Aapjedotinfo/atlantic-aurea-esphome/README.md

# Aurea WP — de complete controlbox van de Atlantic Aurea vervangen

Alternatieve besturing voor de **Atlantic Aurea 5 Hybrid** warmtepomp (een
kostenbespaarde **Chofu AEYC-0643XU**). In de controlbox zitten twee ATmega8's in
een DIP28-voet. **IC1 vervang je altijd door een ESP32; wat je in IC2 zet, bepaalt hoe ver
je komt met thermostaat en CV-ketel** (zie *Kies je opzet*):

| Voet | Origineel | Wordt | Doet |
|---|---|---|---|
| **IC1** | Haddon M1.1 | **ESP32** (MH-ET MiniKit) | praat op 666 baud met de buitenunit, draait de regeling, praat met Home Assistant |
| **IC2** | Haddon T1.1 | naar keuze: leeg, de originele chip, of een **ATmega328P** met eigen firmware | het OpenTherm-gesprek tussen thermostaat en CV-ketel |

Je zegt vanuit Home Assistant *"geef me X °C aanvoer"* en de controller kiest zelf
de stand. Met een chip in IC2 zit de controlbox tussen je thermostaat en je ketel in,
dus kun je de ketel **blokkeren** zolang de warmtepomp het alleen aankan — zonder de
thermostaat te misleiden en zonder draden te verleggen.

**Status: werkend op echte hardware.** Beide kanten van de OpenTherm-brug
decoderen frames zonder pariteitsfouten, met een echte thermostaat aan de ene
kant en een CV-ketel aan de andere. De warmtepompkant draait al langer: alle
telegrammen CRC-geldig, en de buitenunit reageert op de gestuurde stand.

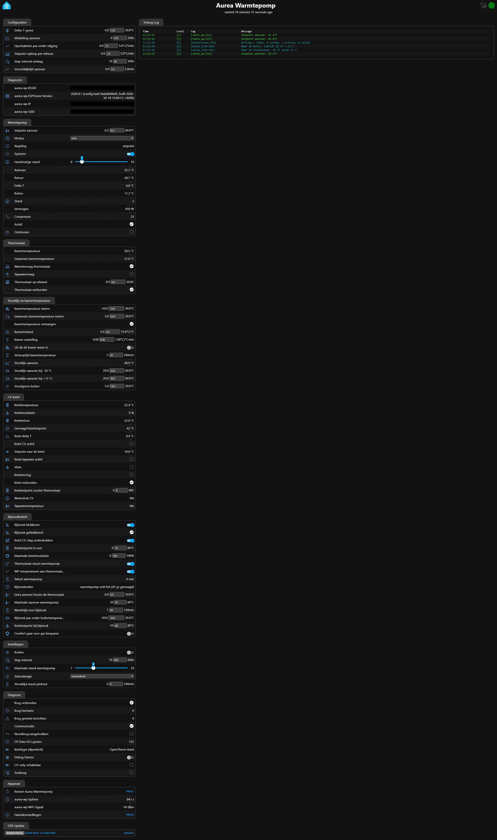
[picture p1: docs/esphome.jpg]
De webinterface, gegroepeerd met web_server v3


---

## Kies je opzet: wat doe je in IC1 en IC2?

**IC1 krijgt altijd de ESP32.** Die doet de warmtepomp: stand, stooklijn, kamertemperatuur, Home Assistant. Voor het
OpenTherm-gesprek tussen thermostaat en CV-ketel loopt er een link tussen IC1 en IC2, en daar zit de keuze. De regel is:
**hoe meer van dat gesprek jij in handen hebt, hoe meer je ziet en kunt sturen.** De originele IC2 voert het gesprek zelf en
geeft alleen twee setpoints door; een eigen AVR geeft elk frame door aan de ESP32.

| | 1. Minimaal | 2. Originele IC2 (`org`) | 3. Eigen AVR **v1** | 4. Eigen AVR **v2** |
|---|---|---|---|---|
| In de IC2-voet | leeg | de originele ATmega8 | ATmega328P, eigen firmware | ATmega328P, eigen firmware |
| Zelf een chip branden | nee | **nee** | ja | ja |
| `avr_versie` in de yaml | (minimaal-voorbeeld) | `"org"` | `"1"` | `"2"` |
| Warmtepomp, stooklijn, kamerregeling | ✅ | ✅ | ✅ | ✅ |
| Kamertemperatuur van de thermostaat | — (via HA of HTTP) | — (via HA of HTTP) | ✅ | ✅ |
| Gewenste kamertemperatuur en ketelsetpoint van de thermostaat | — | ✅ | ✅ | ✅ |
| Ketelgegevens (aanvoer, retour, druk, modulatie, vlam, storing) | — | — | ✅ | ✅ |
| Elk OpenTherm-Data-ID zien | — | — | ✅ | ✅ |
| Ketel tegenhouden zolang de warmtepomp het aankan | — (ketel los) | alles of niets | ✅ met instelbaar setpoint | ✅ met instelbaar setpoint |
| Bijstook op een gekozen ketelsetpoint | — | — | ✅ | ✅ |
| Warmtepomptemperaturen aan de thermostaat tonen | — | ✅ | ✅ | ✅ |
| Buitentemperatuur aan de thermostaat | — | — | — | ✅ |
| Ketelpolariteit instelbaar (schakelaars "Ketel leesrichting/zendpolariteit omkeren", "Kanalen verwisselen") en ketel-diagnose | — | — (staat vast in de originele IC2) | ✅ | ✅ |
| Aan/uit-ketel op het contact van K3 (schakelaar "Ketel aan-uit-contact") | — | ✅ met dipswitch 2 OFF, geen terugmelding | ✅ (ketelklemmen krijgen nog OpenTherm, onschuldig) | ✅ geen OpenTherm naar de ketel |
| Noodbrug als de ESP32 wegvalt | — | ✅ (240 s) | ✅ | ✅ |
| Extra bedrading | alleen GPIO16/17 | + deler op GPIO19 | + deler op GPIO19 | + deler op GPIO19 |
| Terug naar fabrieksstaat | origineel in IC2 | origineel blijft zitten | origineel bewaren | origineel bewaren |
| Getest op echte hardware | ✅ (warmtepomp) | ❌ nog niet | v1 eerder wel; na de herstructurering niet | ✅ één opstelling (26-10-2026) |

**Welke kies je?**

- *Alleen de warmtepomp in Home Assistant, ketel en thermostaat blijven zoals ze zijn:* **1, minimaal.** Ook de beste
  eerste stap om te zien dat je bedrading klopt, en de terugval als er iets mis is.
- *De ketel automatisch laten meewerken, maar je kunt of wilt geen AVR programmeren:* **2, de originele IC2.** Je ziet minder
  en de bijstook is grof, maar je hoeft niets te branden. Experimenteel.
- *Alles zien en sturen, of een ketel/thermostaat die iets bijzonders vraagt:* **4, eigen AVR v2.** Nieuwe bouwers die
  willen branden kiezen v2. v1 blijft werken voor bestaande opstellingen.
- *Een Data-ID, de buitentemperatuur naar de thermostaat of een regeltabel per ID:* alleen **v2**.

De keuze maak je met `avr_versie` bovenin `aurea-wp.yaml`; laat je hem staan, dan compileert het bestand niet (de
foutmelding noemt `avr-brug-vKIES_1_2_OF_ORG...`). Optie 1 kies je door het minimaal-voorbeeld over `aurea-wp.yaml` heen te
kopiëren. Meer per optie hieronder.

### Optie 1: minimaal (IC2-voet leeg)

`aurea-wp.yaml` is de volledige opzet. Wil je alleen de warmtepomp en laat je de
IC2-voet leeg, dan ligt er een uitgeklede variant klaar als
[`aurea-wp-minimaal.yaml.example`](aurea-wp-minimaal.yaml.example):

| | minimaal | volledig |
|---|---|---|
| ESP32 in IC1 | ✅ | ✅ |
| Eigen chip in IC2 | — (voet blijft leeg) | ✅ ATmega328P |
| Warmtepomp aansturen | ✅ volledig | ✅ volledig |
| Stooklijn / kamertemperatuur | ✅ (kamer via HA of HTTP) | ✅ (kamer van de OT-thermostaat, of HA/HTTP) |
| Thermostaat & CV-ketel | los aansturen, zoals voorheen | via de OpenTherm-brug |
| Extra bedrading | alleen GPIO16/17 | + een deler op GPIO19 |

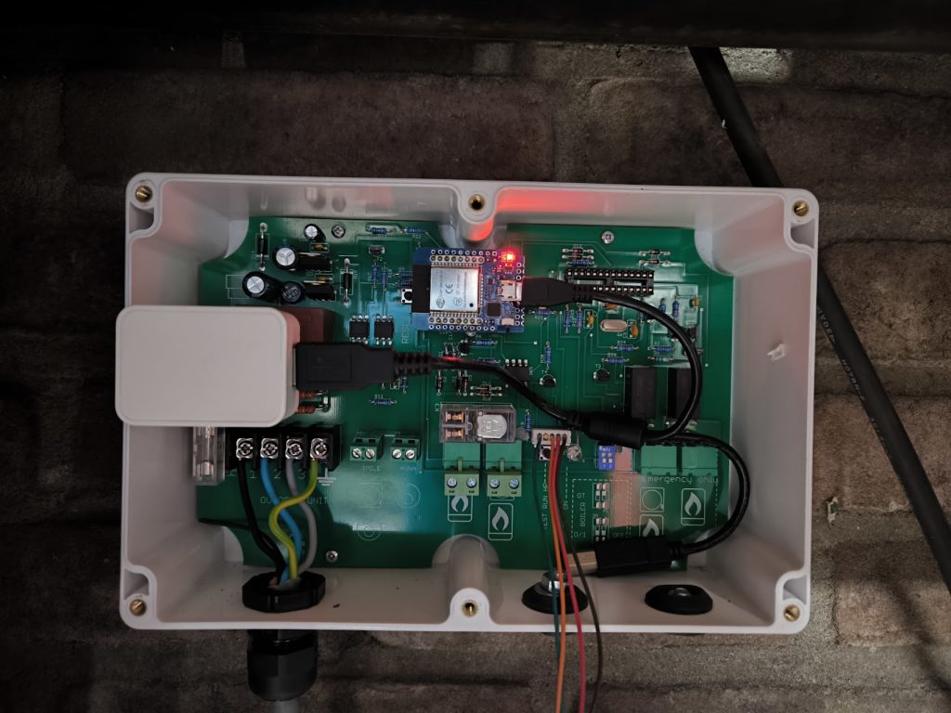
[picture p2: docs/controlbox-esp32.jpg]
Minimale opzet: alleen de ESP32 in de IC1-voet


***Minimale opzet.*** *De ESP32 op de plek van de linker ATmega; de rechter voet
blijft leeg. De warmtepomp draait volledig, de CV-ketel stuur je los aan.*

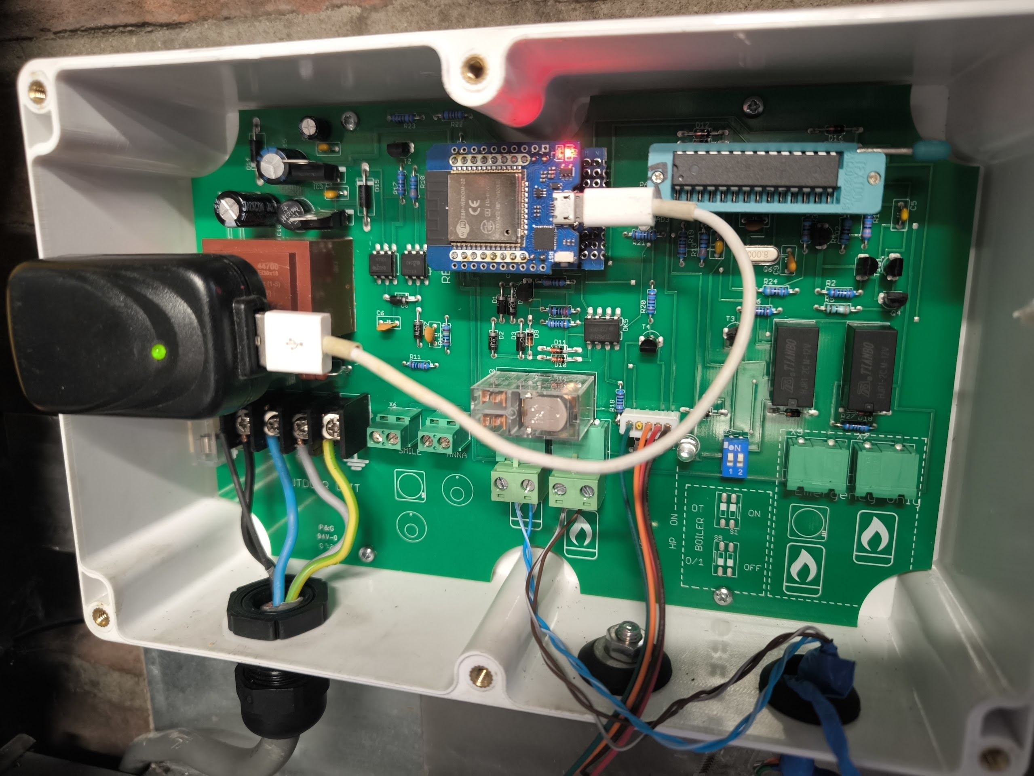
[picture p3: docs/controlboxv2.jpg]
Uitgebreide opzet: beide chips vervangen


***Uitgebreide opzet met IC2-aansturing.*** *Links de ESP32, rechts de eigen
ATmega328P — hier in een ZIF-voet, zodat je de chip zonder gereedschap kunt
wisselen. Voeding via een USB-adapter. Rechtsonder staat op de zeefdruk
`OT BOILER` / `O/1` bij de dipswitch en `Emergency only` bij de klemmen van de
noodbrug.*

Gebruik de minimale opzet door hem over `aurea-wp.yaml` heen te kopiëren:

```bash
cp aurea-wp-minimaal.yaml.example aurea-wp.yaml
```

**Handig om mee te beginnen.** Daarmee heb je de warmtepomp compleet in Home
Assistant en weet je zeker dat je bedrading klopt, vóórdat je een chip gaat
branden. Het is ook waar je op terugvalt als er iets mis is met de brug: de
warmtepomp blijft dan gewoon draaien.

Terug naar de volledige opzet is `git checkout aurea-wp.yaml`, gevolgd door
**`esphome clean aurea-wp.yaml`** — ESPHome kiest zijn bouwmap op de
apparaatnaam, dus de bouwmap van de vorige variant blijft anders staan en je
krijgt een linkfout over ontbrekende `aurea_link`-symbolen.

De apparaatnaam blijft in beide gevallen `aurea-wp`. Dat is bewust: Home
Assistant houdt daarmee het apparaat en de geschiedenis van alle sensoren die in
beide varianten zitten, en je krijgt er bij de volledige opzet alleen de
thermostaat- en ketelentiteiten bij.

### Optie 2: de originele IC2 laten zitten (`avr_versie: "org"`, experimenteel)

De originele ATmega8 (Haddon T1.1) kan gewoon in de IC2-voet blijven. Hij doet zelf het OpenTherm-gesprek met thermostaat en
ketel; de ESP32 praat met hem over de 9615-baud-link die al op de print ligt en speelt de rol van de originele IC1. Je hoeft
dan niets te branden. De prijs: de IC2 geeft veel minder door (geen kamertemperatuur, geen ketelgegevens, geen
buitentemperatuur naar de thermostaat, de ketelrem is alles-of-niets) en deze variant is **nog niet op een echte IC2
geprobeerd**. Begin met `org_alleen_luisteren: "true"`. Alles staat in [docs/ic2-origineel.md](docs/ic2-origineel.md).

### Optie 3 en 4: een eigen AVR in IC2 (v1 of v2)

Zit er een ATmega328P-brug in IC2, dan zijn er twee versies. Ze praten een ander protocol met de ESP32, dus de
firmware van de AVR en de yaml moeten bij elkaar passen:

| | AVR-brug **v1** | AVR-brug **v2** |
|---|---|---|
| Firmware | `firmware/avr-bridge/avr-bridge.hex` | `firmware/avr-bridge-v2/avr-bridge-v2.hex` |
| Link naar de ESP32 | 9600 baud | 38400 baud met CRC |
| Component | `aurea_link` | `aurea_link2` |
| Extra | | regeltabel per Data-ID, **buitentemperatuur naar de thermostaat (werkt alleen vanaf AVR v2)**, automatische TX-polariteit, versie in Diagnose |

**Nieuwe bouwers: kies v2.** v1 blijft werken voor bestaande opstellingen, maar krijgt geen nieuwe functies meer (de
buitentemperatuur naar de thermostaat werkt alleen met v2). De v1-variant van deze yaml compileert, maar is na de
herstructurering (keuze via `avr_versie`) niet op hardware gedraaid; ging het bij jou mis, dan staat de vorige stand op
de tag `voor-v2`. AVR v2 draait sinds 26-10-2026 op één opstelling (OpenTherm-ketel, Remeha iSense); op andere ketels
en thermostaten is hij nog niet getest.

**Bovenin `aurea-wp.yaml` staat `avr_versie`.** Zet die op `"1"` of `"2"`, naar de AVR die je hebt gebrand, of op `"org"` als je
de originele IC2 laat zitten (zie hieronder). Laat je hem staan, dan compileert het bestand niet (de foutmelding noemt
`avr-brug-vKIES_1_2_OF_ORG...`): je moet dus bewust kiezen.
Kies je de verkeerde versie, dan praten ESP32 en AVR niet met elkaar: *Brug verbonden* blijft uit en de warmtepomp
doet niet mee, terwijl de ketel de thermostaat blijft volgen (de brug valt terug; bij v2 na enkele minuten). Welke versie in de ESP32 verwacht wordt, zie je terug onder **Diagnose**
(*AVR-versie (verwacht)*; bij v2 ook *AVR-versie (gemeld)*). Meer over v2: [docs/avr-v2.md](docs/avr-v2.md).

## Wat je nodig hebt

### Voor IC1 — de warmtepompkant

Een **ESP32**; ontwikkeld op een MH-ET LIVE MiniKit, maar elk ESP32-bord met de
juiste pinnen vrij werkt. Zie [WIRING.md](WIRING.md).

### Voor IC2 — de OpenTherm-brug *(optioneel)*

Sla dit over als je de minimale opzet draait, of als je de originele IC2 laat zitten (optie 2): dan hoef je niets te
kopen of te branden. Wat hieronder staat gaat over een **eigen AVR** (optie 3 en 4).

Een **ATmega328P-PU in DIP-28**. Dat is dezelfde behuizing als de originele
ATmega8, dus hij past rechtstreeks in de bestaande voet.

> **Waarom een nieuwe chip en niet de originele overschrijven?**
>
> Omdat je terug wilt kunnen. Laat de originele ATmega8 heel en bewaar hem, dan
> is de controlbox in twee minuten weer fabrieksstaat: chips terug in de voet,
> draden los, klaar. Dat telt als je nog garantie hebt, als er een monteur langs
> moet komen, of als je het huis verkoopt. Overschrijf je de originelen, dan is
> die weg afgesloten — de firmware die erop stond krijg je nergens meer.
>
> **En waarom dan een 328P?** Dezelfde behuizing, dezelfde pinout, dezelfde
> registers, dus hij past rechtstreeks in de voet. Hij is overal te krijgen en
> kost een paar euro. Bovendien heeft hij viermaal zoveel flash en tweemaal
> zoveel RAM: de firmware gebruikt nu 7076 bytes, en op een ATmega8 hield je
> daar iets meer dan een kilobyte van over.

Wat je verder nodig hebt:

- Iets om de chip mee te branden. Met een **TL866-II** gaat het zeker goed —
  chip in de ZIF-voet, fuses in een venstertje — maar die kost zo'n €80 en
  verdient zichzelf pas terug als je vaker losse chips brandt. Heb je een
  **Arduino Uno** liggen, dan kan het daar in principe ook mee via de
  ArduinoISP-sketch; die route is uitgewerkt maar **nog door niemand
  uitgeprobeerd**. Beide staan in [firmware/README.md](firmware/README.md).
- **Geen kristal.** Onder de IC2-voet zit er al een van 8 MHz, gewoon op de
  print. De firmware is daarop gebouwd.

**De kant-en-klare hex staat in deze repo**, dus je hoeft geen Arduino-toolchain
te installeren:

```
firmware/avr-bridge/avr-bridge.hex
```

Fuses erbij (zie [firmware/README.md](firmware/README.md) voor de uitleg):

| Fuse | Waarde | Betekenis |
|---|---|---|
| lfuse | `0xFF` | extern kristal 8–16 MHz |
| hfuse | `0xD9` | geen bootloader, EESAVE uit |
| efuse | `0xFD` | brown-out op 2,7 V |

> Laat **RSTDISBL** en **DWEN** met rust. Die maken van de resetpin een gewone
> I/O-pin, en dan komt een normale programmer er niet meer bij.

Wil je eerst op het bureau testen, zonder kristal? Zet `lfuse` dan op `0xE2`
(interne RC, 8 MHz). Dezelfde hex werkt in beide gevallen — de klokbron is een
fuse, geen compileeroptie.

### Verbinding tussen de twee

Geen. De sporen tussen de IC1- en IC2-voet liggen al op de print, gekruist, en
dat is precies wat je nodig hebt: GPIO18/19 van de ESP32 op IC1-pin 3 en 2,
9600 baud. Eén weerstandsdeler aan de RX-kant, verder niets.

---

## Wat de brug in IC2 doet

*Dit geldt voor een eigen AVR (optie 3 en 4). De originele IC2 (optie 2) kan alleen de rem aan of uit zetten en de
warmtepomptemperaturen tonen, zie [docs/ic2-origineel.md](docs/ic2-origineel.md).*

Hij zit **tussen** de thermostaat en de ketel en geeft het OpenTherm-gesprek
letterlijk door, met een paar uitzonderingen die je vanuit Home Assistant
bedient:

- **De bijstook blokkeren.** Aan = de ketel krijgt een setpoint van 10 °C opgelegd en houdt zich
  koest, terwijl de thermostaat gewoon zijn eigen gesprek blijft voeren. De ketel
  wordt dus nooit "uitgezet": tapwater, storingen en diagnostiek blijven werken.
  De AVR houdt zelf een minimale aan- en uittijd van vijf minuten aan zodat er
  niets gaat pendelen.
- **Zelf antwoorden.** Praat de ketel niet mee (of zet je hem bewust buitenspel),
  dan beantwoordt de brug de thermostaat zelf, met de warmtepomp als warmtebron.
- **Temperatuursubstitutie.** De thermostaat de aanvoer/retour van de wármtepomp
  laten zien in plaats van die van de ketel — alleen nodig als de ketelpomp niet
  meedraait en de ketel dus stilstaand koud water meet.

En wat er gebeurt als het misgaat:

**Valt de ESP32 weg, dan trekt de AVR zelf de noodbrug aan.** Op de print zitten
twee relais (K1 en K2) die het complete aderpaar van de thermostaat rechtstreeks
naar de ketel verleggen. Dat is Atlantic's eigen voorziening, en die zit nu in
firmware — dus hij werkt ook als Home Assistant, het netwerk of de ESP32 eruit
ligt. Het huis blijft warm.

De volledige reverse-engineering van beide originele chips staat in een apart
verslag: **[aapje.info/downloads/atlantic](https://aapje.info/downloads/atlantic/)**.
Daar vind je de instructie-voor-instructie analyse van de firmware, en
[de print pin voor pin doorgemeten](https://aapje.info/downloads/atlantic/#print)
— de socket-pinout, de relaistopologie en de twee OpenTherm-interfaces, die
anders dan je zou verwachten niet symmetrisch gebouwd zijn.

---

## Herkomst van het protocol

Het warmtepompprotocol is niet openbaar. Het is gereverse-engineerd door
forumgebruiker **WackoH** in het Tweakers-topic *"Aurea 5 hybrid: interfaces met de
buitenunit en thermostaat"*: de vier telegrammen, de commando- en checksumwaarden,
de hardware-aansluiting en de eerste werkende ATmega2560-sketches (v1.0 van
02-03-2025 en 0.1Beta van 19-03-2025) komen van hem. **_JGC_** dacht in dat topic
mee, en zijn bewerking van die code was de eerste basis voor onze protocol-laag.
Alle credits voor het uitpluizen gaan naar hen, in het bijzonder naar WackoH.

De OpenTherm-kant is daarnaast rechtstreeks uit de originele T1.1-firmware
gehaald, met een zelfgeschreven AVR-disassembler.

## Het warmtepompprotocol

| Aspect | Waarde |
|---|---|
| Fysiek | 666 baud, 8N1, via 2× H11D1 optocoupler |
| Rollen | **Buitenunit = master** (~500 ms cyclus, ~8 ms startpuls) |
| CRC | CRC-16/CCITT-FALSE (poly 0x1021, init 0xFFFF), big-endian |
| Timing | ESP zendt ~99 ms ná elk ontvangen frame, min. 300 ms tussen TX |

**Zenden (controlbox → WP):** 4 roterende telegrammen. Alleen `data2` verandert;
de rest zijn vaste constanten:

```
data0 = 19 00 08 00 00 00 D9 B5
data1 = 19 01 0C 00 00 00 00 00 00 00 AA 35
data2 = 19 02 08 <modus> <stand> 00 <crc_hi> <crc_lo>   ← het commando
data3 = 19 03 08 B2 02 00 C1 9A
```
`data2` byte 4 = **modus**, byte 5 = **stand** (0–10):

| Modus | Betekenis |
|---|---|
| `0x00` | uit |
| `0x01` | verwarmen |
| `0x02` | **koelen** — ✅ geverifieerd werkend |

> **Koelen werkt echt.** Op het forum stond `0x02` als onbevestigd en de sketches
> gebruikten het nooit. Getest op echte hardware: na het commando startte de
> compressor binnen ~6 s en zakte de aanvoer van 37,8 °C naar 23,8 °C, terwijl de
> retour op 30,0 °C bleef — delta-T van −6,3 °C, dus de aanvoer werd kouder dan de
> retour. Dat is onmiskenbaar koelbedrijf.

**Ontvangen (WP → controlbox):** `91 <ID> <len> <data…> <crc_hi> <crc_lo> 00` — elk
bericht eindigt met een **`00`-eindbyte** (gezien op de lijn bij alle 0x91-berichten;
de lengtebyte + 1 telt hem mee). De CRC staat dus op de twee bytes ervoor. Een frame is
geldig als CRC-CCITT over het **hele** frame, eindbyte inbegrepen, `0` is (een `00`
laat de CRC op 0 staan, dus de controle werkt met en zonder). Berekend per bericht-ID (0–3):

- **ID2** — temperaturen, signed 16-bit **little-endian**, /10:
  byte 3-4 = aanvoer, 5-6 = retour, 7-8 = buiten (bv. `ED 00` = 23.7 °C).
  Let op: ID2 wisselt af tussen twee payload-varianten; de temperatuur-bytes
  staan in beide op dezelfde plek, de staart erna verschilt (nog niet ontcijferd).
- **ID3** — byte 3 = compressorfrequentie (Hz = byte × 2/3), byte 4 = werkelijke ventilator (×10 rpm),
  byte 6 = expansieventiel (×2 pulsen), byte 8 = statusbits (bit 0 = ontdooien), byte 9 = loopt recht mee met
  het vermogen (ongeveer 1,16 × byte 10, geen stroom en geen compressorsnelheid), byte 10 = stroom in 0,1 A (WackoH; A = byte / 10)
  en tegelijk de maat voor het vermogen (W = 25.6 × byte). Over 48 uur tegen een Shelly gelegd: 24 W per telling + ~100 W
  voor pomp en elektronica. 230 V × 0,1 A = 23 W: dat past bij een stroom van 0,1 A per telling.
- **ID1** — byte 3 = bedrijfsstatus (0x50 verwarmen, 0x40 stop voor of tijdens ontdooien, 0x00 uit), byte 4 = **ontdooien
  actief** (0/1), byte 10 = ventilator-setpoint (×10 rpm).
- **ID2, gegevenspagina** (byte 9 = 0): byte 11 = ontdooi-/spoeltemperatuur, byte 12 = zuigtemperatuur (beide raw/2 − 41),
  byte 13 = persgastemperatuur (direct in °C), byte 14 = temperatuur waterzijde (raw/2 − 41).

  Deze velden komen uit de byte-map van **WackoH** (Tweakers, en GitHub issue #1); wij hebben ze op beide units gecontroleerd
  en als sensoren toegevoegd (groep Diagnose). Let op: ID3 byte 13, bij hem een pompindicator (24 uit, 152 aan), staat op onze
  units constant op 24, ook als de unit draait.
  Het vermogen is geijkt tegen een Shelly PM: byte `0x1A` → 25.6 × 26 = 666 W
  tegenover 682 W gemeten (~2 % afwijking).
- **ID1** — nog niet ontcijferd. Byte 4 leek defrost maar blijkt gewoon een
  bedrijfsstatus (0x01 zodra de unit draait), dus die sensor is verwijderd.

### Timing is kritisch

De buitenunit is master en verdraagt geen verkeer terwijl hij zendt. Zend daarom
**alleen als de lijn stil is**: minimaal 40 ms geen byte ontvangen (bij 666 baud
duurt één byte ~15 ms). Vertrouw daarbij niet op je parser-state — die kan
ontsporen op een corrupt frame, waarna je dwars door de warmtepomp heen gaat
zenden en álle lange frames sloopt. Je herkent dat probleem aan `0x19`-bytes
(je eigen telegram) middenin een ontvangen frame.

## Regeling

**"Geef me X°C aanvoer" → de controller kiest zelf de stand.** Waar die X
vandaan komt kies je met **Modus**:

| Modus | Doel aanvoer |
|---|---|
| `auto` | **Setpoint aanvoer**. Met *Thermostaat stuurt warmtepomp* aan zet de OpenTherm-thermostaat dat: haar aanvoervraag (Data-ID 1) |
| `stooklijn` | uit de buitentemperatuur (de voeler op de buitenunit) |
| `kamertemperatuur` | stooklijn + correctie op de kamertemperatuur: van de OpenTherm-thermostaat als die er is, anders uit *Kamertemperatuur extern* |
| `handmatig` | geen regeling, een vaste stand (**Handmatige stand**) |

Koelen gebruikt altijd het vaste setpoint. De sensor **Doel aanvoer** laat zien
waar de regeling op dat moment op mikt, en de tekstsensor **Regeling** waarom
("stooklijn", "boven de stookgrens", …).

Het **bijstookbeleid** (ketel blokkeren, bijspringen bij tekort) werkt in alle
modi behalve handmatig, zolang *Thermostaat stuurt warmtepomp* aan staat. In
`stooklijn` en `kamertemperatuur` bepaalt de warmtepomp zelf wanneer er
warmtevraag is; de thermostaat is dan niet nodig.

### Van doel naar stand

Op basis van de aanvoerfout én de **delta-T** (aanvoer − retour):

| Aanvoer t.o.v. doel | Delta-T | Actie |
|---|---|---|
| Te koud | laag (< Delta-T-grens) | stand **omhoog** |
| Te koud | al hoog (≥ Delta-T-grens) | **houden** — retour warmt vanzelf op |
| Rond doel | hoog (> Delta-T-grens) | stand **omlaag** |
| Rond doel | in band | **houden** |
| Te warm | — | stand **omlaag** |

Delta-T is hier bewust een **rem**, geen gaspedaal: bij een koude start is delta-T
van nature hoog, en dan nóg meer vermogen geven zou overschieten. Daarbovenop:

- **Stap-modulatie**: max +1 stand per *Stap-interval* (standaard 120 s), zodat
  de compressor niet volgas gaat. Van stilstand naar stand 1 wacht hij nooit
  langer dan 60 s. Terugschakelen gaat sneller (*Stap-interval omlaag*, 30 s),
  behalve de laatste stap naar 0.
- **Stopvertraging** (standaard 10 min, 0 = uit): met warmtevraag stopt de
  compressor niet meer bij een kleine overschrijding op stand 1. De regeling
  moet eerst zo lang achter elkaar naar 0 willen, en alleen als de voorspelde
  aanvoer na een stop (retour + (aanvoer - retour) x e^-t, t = vooruitkijktijd)
  boven het setpoint zou blijven. Zo gaat hij niet uit om een minuut later
  weer te starten. Zonder warmtevraag stopt hij direct, zoals voorheen.
- **Middeling**: de aanvoer zaagt bij draaiende compressor ~3-4 °C per minuut.
  De regeling kijkt daarom naar het gemiddelde over 120 s, niet naar één meting.
- **Vooruitkijken**: bij stand 3-4 stijgt de aanvoer 1-2 °C per minuut. De
  regeling beoordeelt de aanvoer zoals hij over 2 minuten verwacht wordt: komt
  hij er vanzelf, dan geen stand erbij; schiet hij ruim door, dan eerder terug.
- **Niet opschakelen zolang de aanvoer nog stijgt** (> 1 °C in 5 min): de vorige
  stap werkt dan nog door.
- **Setpoint-oploop**: het doel schuift hooguit 1 °C per minuut omhoog; omlaag
  gaat direct. Een sprong in het setpoint duwt de unit zo niet in één keer naar
  een hoge stand.

Allemaal instelbaar in de groep **Instellingen**; 0 zet een functie uit.

Bij **koelen** keert de regeling om: dan is de fout `aanvoer − doel` en de
delta-T `retour − aanvoer`, waardoor dezelfde tabel blijft gelden.

**Setpoint-bereik: 6,5 – 60 °C**, het volledige technische bereik uit de
Chofu-datasheet (*Operating Range / Leaving Water Temperature*: koelen `6.5℃~`,
verwarmen `~60℃`). Atlantic noemt 55 °C, maar dat is hun overdrachtspunt naar de
gasketel — geen hardwarelimiet.

**Maximale stand warmtepomp**: het origineel kent stand 1 t/m 10, maar dat is
niet voor elke buitenunit bewezen. Verhoog stapsgewijs en kijk of *Vermogen* en
*Compressor* meestijgen. Met *Vervaltijd stand-plafond* op 0 blijft een plafond
staan; anders valt hij na die tijd terug naar vol vrij.

**Systeem** is een vrijgave en staat na een herstart weer zoals hij stond
(standaard aan). Met de koppeling aan beslist de thermostaat wannéér de
warmtepomp draait; uit betekent warmtepomp stil.

### Stooklijn

Twee punten: de aanvoer bij **−10 °C** en bij **+15 °C** buiten, met een rechte
lijn ertussen en daarbuiten vast. Grofweg 50 / 30 voor radiatoren, 35 / 25 voor
vloerverwarming. Boven de **Stookgrens buiten** (18 °C) is er geen warmtevraag;
weer aan als het 1 °C kouder is.

### Kamertemperatuur

De stooklijn, plus **Kamerinvloed** × (gewenst − gemeten): bij 4 °C/°C en een
kamer die een halve graad te koud is komt er 2 °C aanvoer bij. Daar kun je
desgewenst bij zetten:

- **Kamer-nastelling** (standaard 0 = uit): telt per minuut wat aanvoer op zolang
  de kamer te koud is, zodat hij het doel ook echt haalt. Begin klein (0,1).
- **Uit als de kamer warm is** (standaard uit): unit uit zodra de kamer *Kamer: uit boven doel*
  (standaard 0,2 °C) boven het doel komt, weer aan als hij *Kamer: aan onder doel* (standaard 0,2 °C)
  eronder zakt. Beide los instelbaar, 0 tot 1 °C. *Kamer: minimale schakeltijd* (standaard 0 = uit, tot 120 min)
  houdt de gekozen toestand minstens zo lang vast, tegen pendelen door koken en apparaten. Staat deze uit, dan
  blijft de stooklijn altijd gelden en schuift de kamer hem alleen op. Let op: dan is er altijd warmtevraag
  en blijft de aanvoer minimaal op 20 °C staan, ook als de kamer boven het doel zit (bijvoorbeeld bij een
  nachtverlaging). De unit draait dan in cycli: aan tot de aanvoer boven 20 °C komt, uit, en weer aan zodra
  hij eronder zakt. Wil je dat niet, zet deze optie dan aan, eventueel met een minimale schakeltijd van 15 tot 30 min.

Waar de kamertemperatuur vandaan komt:

1. **Een OpenTherm-thermostaat aan de brug** die zijn kamertemperatuur meldt:
   die, met zijn gewenste temperatuur. Niets in te stellen.
2. Anders **Kamertemperatuur extern**, met **Gewenste kamertemperatuur extern**
   als doel. Die moet je zelf aanleveren, en regelmatig, ook als hij niet
   verandert. Komt er langer dan de *Verlooptijd kamertemperatuur* (30 min)
   niets, dan gaat de unit **uit**; *Kamertemperatuur ontvangen* laat zien of
   hij nog vers is.

Met Home Assistant, bijvoorbeeld:

```yaml
automation:
  - alias: Kamertemperatuur naar de warmtepomp
    triggers:
      - trigger: state
        entity_id: sensor.woonkamer_temperatuur
      - trigger: time_pattern
        minutes: "/5"
    conditions:
      - condition: template
        value_template: "{{ states('sensor.woonkamer_temperatuur') | is_number }}"
    actions:
      - action: number.set_value
        target:
          entity_id: number.aurea_warmtepomp_kamertemperatuur_extern
        data:
          value: "{{ states('sensor.woonkamer_temperatuur') }}"
```

Zonder Home Assistant gaat het met een HTTP-POST, zie
[Gebruik je dit zonder Home Assistant?](#gebruik-je-dit-zonder-home-assistant).

Overige vaste grenzen (`dt_low`, `setpoint_min/max`, `cooling_min_supply`) staan
als opties in `aurea-wp.yaml` onder `chofu_wp:`.

## Entiteiten

De webinterface draait op **web_server versie 3** en groepeert alles; in Home
Assistant zie je dezelfde namen.

| Groep | Wat erin zit |
|---|---|
| **Warmtepomp** | Setpoint aanvoer, Doel aanvoer, Regeling, Modus, Systeem, Handmatige stand, Aanvoer, Retour, Delta T, Buiten, Stand, Vermogen, Compressor, Actief, Ontdooien |
| **Thermostaat** | Kamertemperatuur, Gewenste kamertemperatuur, Warmtevraag, Tapwatervraag, Thermostaat op afstand, Verbonden |
| **Stooklijn en kamertemperatuur** | Kamertemperatuur extern, Gewenste kamertemperatuur extern, Kamertemperatuur ontvangen, Kamerinvloed, Kamer-nastelling, Uit als de kamer warm is, Kamer: uit boven doel, Kamer: aan onder doel, Kamer: minimale schakeltijd, Verlooptijd kamertemperatuur, Stooklijn aanvoer bij −10 / +15 °C, Stookgrens buiten, Stooklijn aanvoer |
| **CV-ketel** | Keteltemperatuur, Ketelretour, Ketel delta T, Ketelmodulatie, Gevraagd ketelsetpoint, Setpoint naar de ketel, CV actief, Tapwater actief, Vlam, Ketelstoring, Verbonden, Ketelsetpoint zonder thermostaat, Waterdruk CV, Tapwatertemperatuur |
| **Bijstookbeleid** | Thermostaat stuurt warmtepomp, Bijstook blokkeren, Bijstook geblokkeerd, Ketelsetpoint in rust, Tekort warmtepomp, Bijstookreden, Maximale aanvoer warmtepomp, Extra aanvoer boven de thermostaat, Wachttijd voor bijstook, Bijstook pas onder buitentemperatuur, Ketelsetpoint bij bijstook, Maximale ketelmodulatie, Comfort gaat voor gas besparen, WP-temperaturen tonen |
| **Instellingen** | Koelen, Stap-interval, Stap-interval omlaag, Stopvertraging, Maximale stand warmtepomp, Vervaltijd stand-plafond, Delta-T-grens, Middeling aanvoer, Vooruitkijktijd aanvoer, Opschakelen pas onder stijging, Setpoint-oploop per minuut, Statuslampje |
| **Diagnose** | Brug verbonden, Brug herstarts, Brug gemiste berichten, Communicatie, Noodbrug aangetrokken, Keteltype (dipswitch), CV-only-schakelaar, Testknop, OT Data-ID's gezien, Debug frames |
| **Apparaat** | Restart, Uptime, WiFi Signal |

*Onder **CV-ketel** staat `Gevraagd ketelsetpoint` (wat de thermostaat vraagt)
naast `Setpoint naar de ketel` (wat de brug ervan maakt); het verschil is de
blokkade. `Waterdruk CV` en `Tapwatertemperatuur` staan op NA omdat deze ketel
die Data-ID's niet beantwoordt.*

*De **CV-only-schakelaar** en de **Testknop** zijn de twee bedieningselementen
op de voorkant van de controlbox (voetpen 23 en 24 van IC1). Je kunt er in Home
Assistant automations aan hangen.*

Twee dingen om te weten over **Diagnose**:

*Brug verbonden* is je enige venster op de chip in IC2 — daar zit geen seriële
monitor en geen LED op. Valt hij weg, dan valt de brug terug op ongewijzigd
doorgeven en blijft je huis warm, maar dan weet je het tenminste. *Brug
herstarts* en *Brug gemiste berichten* vangen de twee manieren waarop dat sluipend
kan gebeuren: een resetlus in de AVR, en een verslechterende seriële link.

Fail-safe aan de warmtepompkant: >60 s zonder geldig telegram → terug naar
stand 0.

## Schema's

Twee printjes die bij dit project horen, als schema (PDF). Gerbers en
KiCad-bestanden zijn er niet; teken ze gerust zelf na.

- [`docs/schema/adapter-ic1-schema.pdf`](docs/schema/adapter-ic1-schema.pdf)
  &mdash; tussenprint voor de IC1-voet: ESP32 MiniKit op de plek van de
  ATmega8L, met de delers voor RX en de brug, de CV-only-schakelaar en de
  testknop, en acht extra voetpennen achter losneembare bruggen.
- [`docs/schema/interfaceprint-buitenunit-schema.pdf`](docs/schema/interfaceprint-buitenunit-schema.pdf)
  &mdash; losse interface voor een buitenunit zonder controlbox: de
  stroomlus op klem 2/3 via twee H11D1 naar een ESP32. De buskant hangt
  galvanisch aan het net; lees de notities op het schema.

## Structuur

```
aurea-wp-666/
├── aurea-wp.yaml                    volledige opzet: warmtepomp + brug
├── avr-brug-v1.yaml                 het stuk van aurea-wp.yaml dat bij AVR v1 hoort (wordt automatisch geladen)
├── avr-brug-v2.yaml                 idem voor AVR v2
├── aurea-wp-minimaal.yaml.example   alleen de warmtepomp, IC2-voet leeg
├── secrets.yaml.example    kopieer naar secrets.yaml en vul in
├── WIRING.md               bedrading + ASCII-schema
├── components/
│   ├── chofu_wp/           666-baud protocol + regeling (warmtepomp)
│   ├── aurea_link/         9600-baud link naar de brug in IC2 (AVR v1)
│   └── aurea_link2/        38400-baud link naar de brug in IC2 (AVR v2)
├── firmware/
│   ├── avr-bridge/         de OpenTherm-brug v1: bron + kant-en-klare .hex
│   └── avr-bridge-v2/      de OpenTherm-brug v2: bron + kant-en-klare .hex
└── docs/
    ├── volledige-controlbox.md   het ontwerp van de tweechip-opzet
    ├── avr-v2.md                 de AVR-brug v2
    ├── print-doormeten.md        werklijst voor de meter
    └── meetresultaten-ic2.md     wat er daadwerkelijk gemeten is
```

## Aan de slag

**Bedrading eerst:** zie [WIRING.md](WIRING.md).

Daarna kun je twee kanten op voor de ESP32. Kies er één als thuisbasis: beide
kunnen OTA flashen, maar ze weten niets van elkaars wijzigingen.

### A. Vanaf je eigen machine

```bash
git clone https://github.com/Aapjedotinfo/atlantic-aurea-esphome
cd atlantic-aurea-esphome
cp secrets.yaml.example secrets.yaml   # wifi + api-sleutel invullen
esphome run aurea-wp.yaml              # eerste keer via USB, daarna OTA
```

Zet eerst `avr_versie` bovenin `aurea-wp.yaml` op `"1"`, `"2"` of `"org"` (zie *Kies je opzet*), anders compileert het bestand niet.

Geen Home Assistant? Zie [docs/esp-updaten-zonder-ha.md](docs/esp-updaten-zonder-ha.md): bouwen en flashen met ESPHome op je
eigen pc, het dashboard of ESPHome Web.

Nog geen chip in de IC2-voet? Kopieer dan eerst
`aurea-wp-minimaal.yaml.example` over `aurea-wp.yaml` heen.

### B. In de Home Assistant ESPHome Device Builder

Je hoeft geen bestanden te kopiëren: de componenten worden rechtstreeks uit deze
repo gehaald, dus alles kan in de webinterface.

1. **+ NEW DEVICE** → naam `aurea-wp` → ESP32 → *Skip* bij het installeren.
2. Klik **EDIT** en vervang de gegenereerde inhoud door die van
   [`aurea-wp.yaml`](aurea-wp.yaml) &mdash; of van
   [`aurea-wp-minimaal.yaml.example`](aurea-wp-minimaal.yaml.example) als je
   de IC2-voet leeg laat. Wissel daarin het
   `external_components`-blok en het `packages`-blok voor:

   ```yaml
   external_components:
     - source:
         type: git
         url: https://github.com/Aapjedotinfo/atlantic-aurea-esphome
         ref: main
       components: [chofu_wp, aurea_link, aurea_link2, aurea_link_org]

   packages:
     avr_brug:
       url: https://github.com/Aapjedotinfo/atlantic-aurea-esphome
       ref: main
       files:
         - avr-brug-v${avr_versie}.yaml
   ```

   Zet ook `avr_versie` bovenin op `"1"`, `"2"` of `"org"` (zie *Kies je opzet*).
   Bij de minimale opzet mogen `aurea_link`, `aurea_link2`, `aurea_link_org` en het `packages`-blok weg.

3. Menu rechtsboven → **Secrets** → `wifi_ssid`, `wifi_password`,
   `fallback_password` en `api_encryption` toevoegen.
4. **INSTALL** → *Wirelessly*.

> **Wissel je van A naar B?** Neem dan je bestaande `api_encryption` mee en
> houd `name: aurea-wp` gelijk. Met een nieuwe sleutel verliest Home Assistant
> de verbinding, en met een andere naam krijg je er een tweede device bij.

> ESPHome cachet git-bronnen. Update je later een component in deze repo, zet dan
> tijdelijk `refresh: 0s` bij `external_components` (naast `source:` en `components:`,
> dus niet erbinnen) en bij `packages` (naast `files:`), anders bouwt hij door op de
> oude kopie.

Liever tóch lokale bestanden in de addon? Zet dan de yaml van je keuze in
`/config/esphome/` en de mappen `components/chofu_wp/` en
`components/aurea_link/` in `/config/esphome/components/`; het
`external_components`-blok blijft dan ongewijzigd, want `path: components` is
relatief aan de yaml.

## Gebruik je dit zonder Home Assistant?

Dat kan. Alles werkt via de webpagina op `http://aurea-wp.local`, instellingen
worden in de ESP zelf bewaard en de tijd komt via SNTP.

ESPHome heeft in het `api:`-blok een waakhond die **standaard op 15 minuten**
staat: verbindt er in die tijd geen enkele API-client, dan herstart het apparaat.
**De webinterface telt daar niet mee** — die draait op poort 80 en staat los van
de native API op 6053. Zonder Home Assistant zou hij dus elk kwartier herstarten.
Daarom staat die waakhond in deze yaml uit:

```yaml
api:
  reboot_timeout: 0s
```

Een vastgelopen wifi vangt de wifi-waakhond nog steeds op (herstart na 15
minuten zonder netwerk).

De kamertemperatuur voor modus `kamertemperatuur` (als er geen
OpenTherm-thermostaat is) zet je met een HTTP-POST, bijvoorbeeld vanuit
Node-RED, Domoticz of een script:

```bash
curl -X POST "http://aurea-wp.local/number/Kamertemperatuur%20extern/set?value=20.5"
```

Gebruik je Home Assistant wél en verbindt hij niet? Controleer of het apparaat
er als device in staat, of `api_encryption` in je `secrets.yaml` overeenkomt met
wat HA heeft opgeslagen, en kijk naar de sensor `WiFi Signal` — rond of onder
−80 dBm helpt geen enkele instelling.

## Diagnose

Zet de **"Debug frames"**-switch aan (web-GUI of Home Assistant) om elk ontvangen
frame als hex te loggen met CRC-resultaat:

```
FRAME ID2 [19] 91 02 12 ED 00 E1 00 C6 00 ... crc=0000 OK
```

Zo zie je meteen of er schone telegrammen binnenkomen. Laat 'm normaal uit voor een
rustige log.

## ⚠️ Disclaimer

Je past hardware in je warmtepomp-controlbox aan die op netspanning zit en
(mogelijk) onder garantie valt. Doe dit alleen als je weet wat je doet, en op
eigen risico. Dit project is niet gelieerd aan of goedgekeurd door Atlantic/Chofu.
Het protocol is reverse-engineered en kan per model/firmware verschillen.

**Koelen:** een CV-systeem is meestal niet geïsoleerd tegen koud water. Onder het
dauwpunt gaan leidingen en radiatoren **condenseren** — met kans op waterschade.
Houd het setpoint hoog genoeg (vuistregel: boven ~17 °C) of isoleer je leidingen.

**De dipswitches op de print.** Dip 2 zit op socket-pin 25 (PC2) en bepaalt het
keteltype: **ON = OpenTherm-bedrijf.** Op OFF is het een aan/uit-ketel: er komt geen
OpenTherm-verkeer naar de ketel (de originele T1.1 speelt dan zelf slave).

**Aan/uit-ketel op K3.** K3 (socket-pin 28, PC5) is een relais met een droog wisselcontact
van 10 A; de frontschakelaar zit in serie en moet dicht. K3 sluit bij een ketelsetpoint van
20 °C of meer en blijft open zolang de rem aan staat. Met AVR v1/v2: zet de schakelaar
"Ketel aan-uit-contact" aan (standaard uit). Met de originele IC2: dipswitch 2 op OFF.
Valt de ESP32 weg, dan gaat K3 bij v2 open; bij v1 en het origineel volgt hij de thermostaat.
Nog niet op hardware getest.

## Credits

- **WackoH** (Tweakers) — reverse-engineering van het warmtepompprotocol
  en de eerste werkende sketches.
- **_JGC_** (Tweakers) — meedenken en een eerste werkende versie waar dit
  project mee begon.
- Regeling, ESPHome-componenten, de AVR-brug en de documentatie: dit project.
