Aapjedotinfo/atlantic-aurea-esphome/docs/avr-v2.md

# AVR-brug v2

**Status: draait sinds 26-10-2026 op één opstelling (OpenTherm-ketel, Remeha iSense): 0 gemiste berichten, 0 herstarts van de brug. Andere ketels en thermostaten zijn nog niet getest. Begin op de bank met de ketel geblokkeerd.**
Kies de versie met `avr_versie` bovenin `aurea-wp.yaml`; de yaml en de AVR-firmware moeten dezelfde versie zijn.

Naast v1 en v2 is er `avr_versie: "org"`: de originele IC2 blijft zitten, zonder eigen firmware en met veel minder functies.
Een vergelijking van alle opties staat onder *Kies je opzet* in de [README](../README.md).

Een nieuwe versie van de ATmega328P-brug (firmware/avr-bridge-v2) met een nieuw protocol tussen de ESP32 en de AVR,
en het bijbehorende ESPHome-component `aurea_link2`. De huidige brug (firmware/avr-bridge) blijft onveranderd.

## Wat is nieuw
- Link ESP32 naar AVR op **38400 baud** met een eigen berichtformaat (HELLO, TABEL, VRAAG/ANTWOORD, STATUS, COMMANDO), CRC-8, en
  volgnummers zodat een verlaat ketelantwoord nooit bij de verkeerde vraag terechtkomt.
- Een **regeltabel per Data-ID en richting** (doorgeven, vaste waarde, vraag de ESP32, blokkeren) die de ESP32 instelt en na elke
  herstart opnieuw naar de AVR stuurt. In ESPHome: `onderscheppen:` en de trigger `on_vraag`.
- **Veilige opstart:** geremd, CH-vlag onderdrukt, de noodbrug pas na 240 s zonder ESP32 (v1: direct).
- De AVR meldt zijn **softwareversie** (HELLO).
- **TX-polariteit** naar de thermostaat is vanuit de ESP32 omkeerbaar (runtime-vlag). De Honeywell Chronotherm Touch werkt
  (met de polariteit van het origineel, PD4 rust hoog); de Remeha iSense werkt ook. Anna werkte met de oude polariteit. Het kiest de polariteit zelf
  (*TX-polariteit automatisch* in `avr-brug-v2.yaml`); handmatig kan met *TX-polariteit thermostaat omkeren*.

## Niet compatibel met v1
Een v2-AVR praat niet met de oude ESP-firmware (`aurea_link`) en andersom: beide kanten moeten tegelijk naar v2. Branden met
dezelfde fuses als v1 (lfuse 0xFF, hfuse 0xD9, efuse 0xFD), zie `firmware/avr-bridge-v2/README.md`.

## Waar te beginnen
1. `firmware/avr-bridge-v2/PROTOCOL.md`: het protocol (bytelayouts, tijden, de standaardtabel).
2. `firmware/avr-bridge-v2/README.md`: bouwen, branden en een bankplan.
3. `docs/aurea-link2.yaml.example`: een compileerbaar voorbeeld van de ESP-kant (alleen het component `aurea_link2` nodig).
