Aapjedotinfo/atlantic-aurea-esphome/docs/controlbox-optos-componentzijde.jpg

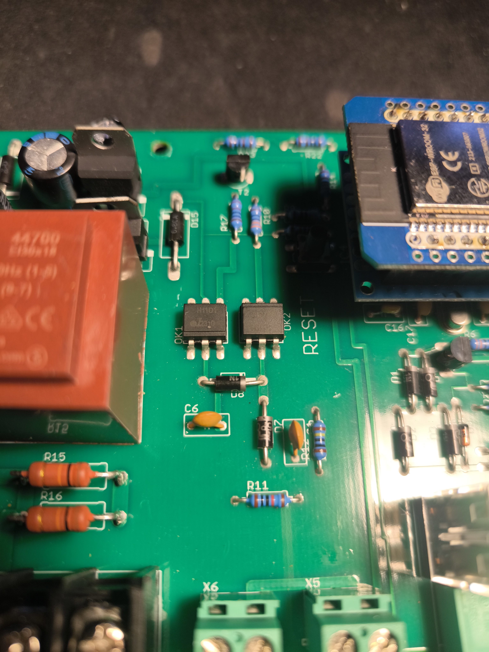
docs/controlbox-optos-componentzijde.jpg
