Aapjedotinfo/atlantic-aurea-esphome/docs/controlbox-optos-soldeerzijde.jpg

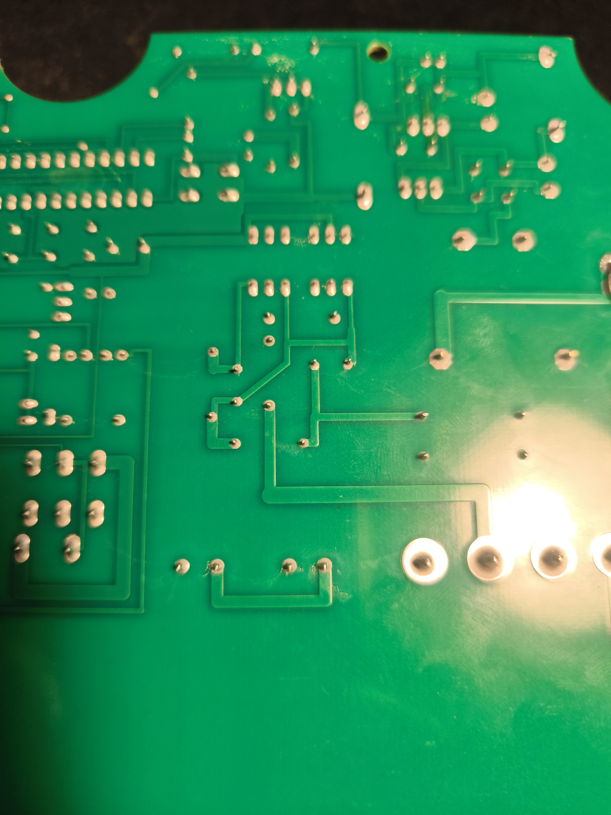
docs/controlbox-optos-soldeerzijde.jpg
