Aapjedotinfo/atlantic-aurea-esphome/docs/handleiding-installatie-a4.html

# Installatie ESP32 + AVR-brug in de Atlantic Aurea-controlbox

Spanningsloos werken: stekker eruit, voeding van de controlbox af. Alleen aan de 5 V-kant, niet aan de netspanning-/powerline-delen.

PIN 1 EERST. Elke chip en elke adapter heeft een pin 1. Staat hij 180° gedraaid, dan werkt het niet en kan er iets stuk gaan. Pin 1 vind je aan de kerf (halve maan) of de stip op de chip. Die kerf moet aan dezelfde kant zitten als de kerf/markering van de voet op de print. Leg de chip altijd eerst zonder duwen in de voet en kijk of de kerven op één lijn liggen. Raadpleeg bij twijfel de zeefdruk bij de voet, niet je gevoel.

## Pin-nummering (DIP-28, bovenaanzicht)

Linkerrij loopt van boven naar beneden (1 → 14), rechterrij van beneden naar boven (15 → 28). Pin 28 staat dus naast pin 1.

## 1. Wat komt waar

Voet | Wat erin
IC1 (links, warmtepomp) | Adapterprint met de ESP32
IC2 (rechts) | ATmega328P-PU met de brug-firmware

- Haal beide originele ATmega8L-chips uit hun voet en bewaar ze (terug naar fabrieksstaat = chips terugzetten).
- Chip uit de voet: gebruik een chip puller. Heb je die niet, wip dan met een klein schroevendraaiertje om en om voorzichtig aan beide kanten, zodat de pootjes niet buigen.
- Controleer na transport eerst alle pootjes van de AVR en de adapterprint: staan ze netjes recht en parallel, en is er niets omgebogen of ingeklapt? Een scheef pootje bij het indrukken breekt af of buigt onder de chip. Buig het voorzichtig recht (bijv. door de chip op zijn zij tegen een vlak tafelblad te drukken) vóór je plaatst.
- Pootjes uitgelijnd op de gaatjes, dan pas gelijkmatig indrukken.

## 2. Controle vóór het inschakelen

1. Kerf van de adapter én van de AVR ligt aan dezelfde kant als de kerf van de voet; pin 1 klopt.
2. Alle pootjes zaten recht vóór het plaatsen (na transport gecontroleerd), en nu zitten alle pinnen in de voet: geen enkel pootje is omgeslagen of buiten de voet gebleven.
3. Dipswitch 2 op ON (anders knijpt de ketelkant af).

## Aan de thermostaat (Anna e.d.) hoeft niets te veranderen

De thermostaat en de ketel blijven exact zo aangesloten als nu: geen draad verleggen, niets instellen op de Anna. De brug zit in de controlbox tussen beide en geeft het gesprek gewoon door. Valt de ESP32 of het netwerk uit, dan schakelt de controlbox de thermostaat rechtstreeks door naar de ketel, dus het huis blijft warm.

## 3. Inloggen op de hotspot (eerste keer instellen)

1. Zet de voeding aan en wacht ± 1 minuut.
2. Pak telefoon of laptop → wifi-instellingen → kies netwerk Aurea-WP.
3. Wachtwoord: aureahybrid.
4. Een inlogpagina (captive portal) opent vanzelf. Doet hij dat niet: open de browser en ga naar http://192.168.4.1.
5. Kies je eigen wifi-netwerk, vul je wachtwoord in en bevestig.
6. Het apparaat herstart en verbindt met je router; de hotspot verdwijnt. Daarna verschijnt hij in Home Assistant (ESPHome-integratie, zonder sleutel).
- Je telefoon meldt "geen internet": blijf verbonden.
- Hotspot niet te zien? Voeding eraf en weer aan; kom niet verder dan een paar meter.
- Komt hij later niet meer op je wifi (router vervangen)? Na 15 min zonder netwerk start de hotspot opnieuw.
- Zelf gecompileerd met je eigen config? Dan heet de hotspot <naam>_Hotspot met het fallback_password uit je secrets.

# Controlbox: waar komt wat?

Schematisch, gezien van boven met de schroefklemmen (netspanning, buitenunit) onderaan, zoals de box aan de muur hangt. Niet op schaal.

PIN 1 bij IC2 (AVR): de kerf of stip van de chip wijst naar links, naar de ESP32 toe. Pin 1 is de eerste pin links aan de onderste rij. Controleer dit altijd op de zeefdruk bij de voet voordat je indrukt.

- IC1 (links boven): adapterprint met ESP32, USB-poort aan de rechterkant (oranje in het schema). Hierop komt de USB-kabel van de USB-voedingsadapter.
- IC2 (rechts boven): ATmega328P, kerf links.
- Haal de twee originele ATmega8L-chips eruit en bewaar ze.
- Aan de Anna/Smile-klemmen, de ketel-klemmen en de thermostaatkabels verandert niets.

De pin-1-zijde van IC2 is afgeleid van de foto van een bestaande opstelling (kerf links). Die van de adapterprint in IC1 volgt de zeefdruk/kerf van de voet; controleer beide op de eigen print.
