Aapjedotinfo/atlantic-aurea-esphome/(commit log)

2026-07-21 Aurea WP: ESPHome controller op het echte 666-baud protocol
    ESP32 vervangt de controlbox-MCU en praat rechtstreeks met de Chofu-
    buitenunit (666 baud, 4 roterende telegrammen, CRC-16/CCITT). Setpoint
    aanvoer -> zelf stand 0-7 kiezen met delta-T en stap-modulatie.
    Protocol reverse-engineered door WackoH en _JGC_ (Tweakers).
2026-07-22 Koelbedrijf, botsingsfix en volledig fabrieksbereik
    Koelen (data2 byte 4 = 0x02) blijkt te werken - op het forum stond dit als
    onbevestigd en JGC gebruikte het nooit. Geverifieerd op echte hardware:
    compressor start binnen ~6s, aanvoer zakt van 37.8 naar 23.8 graden terwijl de
    retour op 30.0 blijft (delta-T -6.3). Regeling keert bij koelen om, met een
    absolute vorstvloer onder de fabrieksgrens.
    Botsingsfix: alleen zenden als de lijn >=40ms stil is, i.p.v. vertrouwen op de
    parser-state. Die kon ontsporen op een corrupt frame, waarna we dwars door de
    warmtepomp heen zonden en alle lange frames sloopten (0x19-echobytes middenin
    ontvangen frames). Nu halen alle vier de bericht-ID's consistent c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
2026-07-22 Foto van de omgebouwde controlbox toevoegen
    ESP32 op de plek van de linker ATmega, rechter socket leeg, voeding via USB.
    Opgenomen in de repo (docs/) i.p.v. hotlinken, zodat het project self-contained
    blijft. Getoond in zowel README als WIRING.
2026-07-22 README: installatie-instructies voor de ESPHome Device Builder
    Twee duidelijke routes in plaats van een terzijde: lokaal met de esphome
    CLI, of volledig in de Home Assistant-addon. Die tweede route hoeft geen
    bestanden meer te kopieren - het chofu_wp-component komt via
    external_components rechtstreeks uit deze repo, dus alles kan in de
    webinterface.
    Plus de twee valkuilen die je device kosten: een nieuwe api_encryption
    verbreekt de HA-koppeling, en ESPHome cachet git-bronnen.
2026-07-30 Standenplafond van 7 naar 10
    Uit de gedisassembleerde Atlantic-firmware (IC1, "Haddon M1.1") blijkt dat het
    origineel meer standen kent dan wij tot nu toe gebruikten:
    - De zendroutine leest een vooraf uitgerekende telegramtabel met elf varianten
    van het ID2-commando: modus 0x00 (uit) en modus 0x01 met stand 1 t/m 10.
    Alle elf zijn gedecodeerd en hebben een geldige CRC-16/CCITT.
    - De interne stand-variabele wordt begrensd op 40 en de tabelindex is stand/4,
    dus 40/4 = 10. Stand 10 is in het origineel dus daadwerkelijk bereikbaar.
    - Terzijde: de modusbyte is in de hele flash alleen 0x00 of 0x01. Atlantic
    heeft koelbedrijf via deze binnenunit nooit gecommandeerd, wat het label
    "experi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
2026-08-04 De complete controlbox: ESP32 in IC1, eigen ATmega328P in IC2
    Tot nu toe verving dit project alleen de linker microcontroller en bleef de
    rechter voet leeg; de CV-ketel stuurde je los aan. Nu zijn ze allebei vervangen
    en zit er weer een volwaardige OpenTherm-brug tussen thermostaat en ketel - maar
    dan een die wij kunnen aansturen.
    WAT ERBIJ KOMT
    - firmware/avr-bridge: de brug voor de IC2-voet. Geeft OpenTherm door tussen
    thermostaat en CV-ketel, praat op 9600 baud met de ESP32, en trekt zelf de
    noodbrug (K1+K2) aan zodra de ESP32 zwijgt - in firmware, dus ook als Home
    Assistant, het netwerk of de ESP32 eruit ligt. De kant-en-klare .hex staat
    erbij, zodat je geen Arduino-toolchain n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
2026-08-05 Keteltype leest nu wat het is, niet aan/uit
    De dipswitch op socket-pin 25 stond als binaire sensor in de lijst, en dan moet
    je elke keer opnieuw bedenken welke stand wat betekent - zeker omdat de logica
    omgekeerd is: dicht naar massa is laag is OpenTherm.
    Nu een text_sensor die OpenTherm-ketel of Aan/uit-ketel meldt.
2026-08-05 Ketel kon niet meer terugkomen als hij een keer weg was geweest
    Grendel in de brug. De ketel wordt alleen "levend" door een antwoord, en een
    antwoord komt alleen op een vraag. Ging obs.boiler_alive een keer uit terwijl er
    een thermostaat praatte, dan nam de zelfstandige tak voortaan elke beurt over en
    werd er nooit meer iets naar de ketel gestuurd. De eigen poll die dat had kunnen
    opvangen zit achter !obs.stat_alive, dus die sprong ook niet bij.
    Gevolg: "Ketel verbonden" bleef uit tot de AVR opnieuw startte, ook als de ketel
    er allang weer was. Precies wat er gebeurde nadat de ketel-emulator vijf seconden
    los had gezeten.
    Nu proberen we het elke 10 seconden opnieuw door een echte vraag van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
2026-08-05 Minimale opstelling: ESP32 alleen, IC2-voet leeg
    Nieuw bestand aurea-wp-minimaal.yaml. Alleen chofu_wp, geen aurea_link, geen
    tweede UART, geen thermostaat- en ketelentiteiten. De warmtepomp doet daarin
    alles wat hij in de volledige opzet ook doet; je CV-ketel stuur je los aan.
    Dit is de configuratie om mee te beginnen: je hebt de warmtepomp compleet in
    Home Assistant en weet dat je bedrading klopt voordat je een chip gaat branden.
    Het is ook waar je op terugvalt als er iets mis is met de brug.
    Naam blijft aurea-wp, dus overstappen is later alleen de andere yaml flashen -
    Home Assistant houdt het apparaat en de geschiedenis van alles wat in beide
    bestanden zit.
    README beschrijft de keuze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
2026-08-05 Socket-pin 17 en 18 zijn ook niet aangesloten
    Daarmee eindigen alle vijf de pinnen die het origineel als uitgang instelt maar
    nooit beschrijft blind op deze print: 4, 14, 15, 17 en 18. Dat past bij een
    codebasis die over meerdere modellen gedeeld wordt - de firmware stelt ze in,
    deze printversie gebruikt ze niet.
    De commentaarblokken met testschakelaars konden daarmee uit de yaml. De AVR kan
    ze nog steeds aansturen via set_test_out, mocht een andere printversie ze wel
    bedraden. Geen codewijziging in de firmware, dus de hex blijft gelijk.
2026-08-05 Waarschuwing bij het wisselen tussen de twee yaml-bestanden
    ESPHome kiest zijn bouwmap op de apparaatnaam, en die is in beide bestanden
    gelijk. Compileer je eerst de minimale opzet en daarna de volledige, dan blijft
    de bouwmap van de eerste staan en krijg je een linkfout over ontbrekende
    aurea_link-symbolen. Een esphome clean lost het op.
    Dat is de prijs van dezelfde naam houden, en die is het waard: een andere naam
    kost je het apparaat en alle geschiedenis in Home Assistant. Staat nu in de
    README bij de keuze tussen de twee.
2026-08-05 Tweerichtingsbrug: de ESP32 leest en schrijft nu elk frame
    Het statusbericht was een samenvatting van acht waarden die de AVR zelf uitpakte.
    Alles daarbuiten werd gelezen, gebruikt om door te geven, en weggegooid. Elk
    Data-ID dat je erbij wilde kostte een burn.
    LEZEN
    Elk frame dat de brug passeert gaat nu rauw naar de ESP32, in vier richtingen:
    wat de thermostaat vroeg, wat de ketel antwoordde, wat wij naar de ketel
    stuurden en wat wij de thermostaat antwoordden. Die laatste twee laten zien wat
    de brug er zelf van maakt - bij een geblokkeerde bijstook zie je het echte
    setpoint van de thermostaat naast de 10 graden die wij ervan maken.
    F2 <richting> <b3> <b2> <b1> <b0> <som>
    De ESP32 ho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
    [aurea-wp.yaml]
2026-08-05 Keteltemperatuur en modulatie uit de frames, niet uit de samenvatting
    Het statusbericht van de AVR heeft geen houdbaarheidsdatum: obs.boiler_temp
    blijft op de laatste waarde staan die er ooit in kwam. Daardoor stond
    Keteltemperatuur netjes op 40 graden terwijl de ketel ID 25 op dat moment
    afwees met UNKNOWN-DATAID. Een getal dat klopt zolang je niet kijkt.
    Nu uit get_ot(), net als de retour en de druk. Komt er niets binnen, dan blijft
    het veld leeg in plaats van te liegen.
    Meteen erbij: Setpoint naar de ketel, oftewel ID 1 in de richting die de brug
    werkelijk verstuurt. Naast Gevraagd ketelsetpoint - wat de thermostaat vroeg -
    zie je daarmee wat het beleid ervan maakt. Staan ze gelijk, dan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
2026-08-05 Koelen is geen experiment meer
    Werkt aantoonbaar op deze hardware. Het label experimenteel stond er omdat
    Atlantic modus 0x02 nergens in zijn flash gebruikt - alleen 0x00 en 0x01 - en
    dat blijft waar. Maar dat zegt iets over de binnenunit, niet over de
    buitenunit: die begrijpt 0x02 prima.
    Weggehaald uit de yaml, het voorbeeldbestand en chofu_wp. De waarschuwing over
    condensvorming blijft en is scherper gezet: het gaat om het BINNEN-dauwpunt, niet
    het buitendauwpunt. Dat is de fout die je huis nat maakt.
    In het verslag staat nu bij de dekkingscontrole dat de buitenunit meer kan dan
    de binnenunit ooit vroeg - precies de ruimte die je wint door de controller te
    vervangen in plaats van hem te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
2026-08-05 Screenshot van de Xgpro-burn erbij
    Laat in een plaatje zien wat de tekst eromheen uitlegt: de vier bytes die
    moeten kloppen (0xFF / 0xD9 / 0xFD / 0xFF), dat onder Lock Bit Byte alles leeg
    hoort te blijven, en de twee logregels die tellen - de chip-ID en de
    geslaagde verificatie van de flash.
2026-08-05 De thermostaat stuurt de warmtepomp
    Er draaiden twee regelaars die niets van elkaar wisten: de warmtepomp kreeg zijn
    doel van een schuif in Home Assistant, en de brug zag wat de thermostaat vroeg.
    Niemand verbond die twee.
    Dat kan nu rechtstreeks, want een modulerende OpenTherm-thermostaat rekent zelf
    uit welke AANVOERTEMPERATUUR ze wil en vraagt die via Data-ID 1. Dat is precies
    de eenheid die de warmtepomp verwacht - de kamertemperatuur-naar-water-vertaling
    heeft de thermostaat al gedaan. Geen stooklijn nodig.
    DE HYBRIDE-BESLISSING
    De ketel gaat nooit als eerste aan. Drie trappen:
    rust ketel op het rustsetpoint (10 gr) en blijft koud
    bijspringen ketel op een instelbaar niv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
2026-08-05 Opruiming, en de substitutieschakelaar loog tegen de interface
    FOUT VAN MEZELF
    De koppeling zette de temperatuursubstitutie rechtstreeks op het component:
    id(otlink)->set_subst_temp(true);
    Buiten de schakelaar om, dus de substitutie stond aan terwijl de knop in de
    interface uit aangaf. En met de hand aanzetten en weer uit deed niets zichtbaars,
    want dertig seconden later zette de koppeling hem toch weer aan.
    Bij de blokkade had ik het wel goed gedaan - die loopt via id(sw_brake) - maar
    hier niet. Nu allebei via de schakelaar. Wat je ziet klopt dan met wat er is, en
    je ziet meteen DAT de koppeling hem aanzet.
    WEG
    Ketel overslaan: testknop om de zelfstandige antwoorden te controleren z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
2026-08-05 Comfort gaat voor gas besparen staat standaard uit
    Ik had hem op RESTORE_DEFAULT_ON gezet omdat een koud huis erger voelt dan een
    gasrekening. Maar dat is mijn afweging, niet die van dit project: wie deze
    controlbox vervangt doet dat om minder gas te stoken, niet om een regeling te
    krijgen die zelf bedenkt dat het wel weer even mag.
    Nu RESTORE_DEFAULT_OFF. De buitentemperatuurgrens is daarmee absoluut tenzij je
    zelf anders beslist.
2026-08-05 Alleen loggen als er iets verandert
    Sinds het bijstookbeleid de setters elke 30 seconden aanroept logde de
    warmtepomp onvermoeibaar 'Systeem: UIT' terwijl er niets gebeurde. Zulke ruis
    kost je de ene regel die er wel toe doet.
    set_cooling had de bewaking al; set_setpoint, set_system_on en set_auto_mode
    nu ook.
2026-08-06 ArduinoISP als volwaardige weg om de chip te branden
    Ik had de TL866 als de gewone route beschreven en de kosten ervan weggewuifd.
    Die kost zo'n 80 euro; een Uno ligt bij de meeste mensen al in de la. Voor een
    chip die je een keer brandt is dat geen redelijke aanschaf.
    Nu staan beide wegen uitgewerkt, met een vergelijking bovenaan. De valkuil bij
    de ISP-route is de klok: lfuse 0xFF betekent extern kristal, en zet je die op
    een breadboard zonder kristal dan is de chip daarna niet meer aanspreekbaar. Of
    een kristal erbij, of de fuses als laatste doen.
    Plus de waarschuwing over Bootloader branden uit de IDE: de Pro Mini 8 MHz
    definitie zet hfuse 0xDA met BOOTRST geprogrammeerd, en dan start d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
2026-08-06 ArduinoISP-route als onbeproefd markeren
    Ik heb hem afgeleid uit de standaardprocedure plus onze fuses, maar niemand
    heeft deze chip zo gebrand. Dat hoort er expliciet bij: de TL866-route is wel
    beproefd en heeft een screenshot van de geslaagde burn.
    Met de vraag erbij om het in het forumtopic te melden, in beide richtingen -
    werkt het, dan kan dit voorbehoud eruit; werkt het niet, dan staat hier straks
    wat er misging.
2026-08-06 Foto's van beide opstellingen, en waarom je de originele chips heel laat
    De screenshot van de webinterface staat nu bovenaan: wie de repo opent ziet
    meteen wat het oplevert in plaats van een print waar hij nog niets van kan
    plaatsen. De twee foto's van de controlbox staan bij de vergelijkingstabel, waar
    ze iets uitleggen - de minimale opzet met een lege IC2-voet, en de uitgebreide
    met beide chips vervangen.
    WAAROM EEN NIEUWE CHIP
    Er stond alleen dat een 328P meer flash heeft. Het echte argument ontbrak: je
    wilt terug kunnen. Laat de originele ATmega8 heel en bewaar hem, dan is de
    controlbox in twee minuten weer fabrieksstaat. Dat telt bij garantie, bij een
    monteur, en bij verkoop van het h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
2026-08-07 Waarschuwing over reboot_timeout zonder Home Assistant
    ESPHome herstart het apparaat als er 15 minuten lang geen API-client verbindt.
    De webinterface telt daar niet voor mee - die draait op poort 80 en staat los
    van de native API. Wie alles via de webpagina bedient en het apparaat nooit in
    Home Assistant heeft toegevoegd krijgt dus elk kwartier een herstart, eindeloos.
    En omdat Systeem na een herstart uit staat, valt de warmtepomp daarmee elk
    kwartier stil. Die combinatie maakt het onbruikbaar zonder HA.
    Met het verwarrende detail erbij: esphome logs verbindt zelf over die API, dus
    zolang je naar de logs kijkt gebeurt er niets.
2026-08-07 De reboot_timeout-valkuil zichtbaar in de yaml
    Alleen uitleg, geen instelling. De waakhond staat op ESPHome's standaard van 15
    minuten en dat blijft zo; wie hem uit wil zetten leest nu waarom, in plaats van
    erachter te komen doordat zijn warmtepomp elk kwartier stilvalt.
    Staat in beide configuraties, met de logregel erbij zodat wie ernaar zoekt hier
    uitkomt.
    [aurea-wp.yaml]
2026-09-18 De buskant van de warmtepomp-interface doorgemeten
    Tot nu toe stopte de documentatie bij de 5 V-kant van OK1 en OK2. Wat er
    tussen die optocouplers en de klemmenstrook naar de buitenunit zat was nooit
    vastgelegd, en dat was precies het gat dat een nabouw voor een tweede unit
    tegenhield.
    Het blijkt een stroomlus tussen klem 3 en klem 2, met de fototransistor van
    OK2 en de LED van OK1 in serie. Zenden is de lus onderbreken, ontvangen is
    zien of er stroom loopt. Beide kanten zien daarmee ook hun eigen zending;
    die echo hoort bij de topologie en is geen bedradingsfout.
    Nieuw in docs/bom-controlbox.md:
    - het complete schema van de buskant, inclusief de bandrichting van D7 en D8,
    die onafhank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
2026-09-19 Ontdooidetectie en een instelbaar stand-plafond
    Twee toevoegingen aan de hoofd-ESP, allebei ook zonder tweede unit al nuttig.
    Ontdooien wordt nu afgeleid in plaats van uit het protocol gelezen. De byte
    die we er eerder voor gebruikten (ID1 idx4) bleek een bedrijfsstatus en de
    echte defrost-byte is nog niet gevonden, maar nodig is die ook niet: bij
    ontdooien keert de vierwegklep om en haalt de unit warmte uit het water, dus
    zakt de aanvoer onder de retour. Die toestand komt verder nergens voor.
    Koelbedrijf onderdrukt de meting - daar is een negatieve delta juist normaal,
    maar dan is het buitenblok de condensor en valt er niets te ontdooien. De
    vertraging van 30 s vangt de mengtransiënt op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
2026-10-17 Volledige controlbox wordt main: modi, stooklijn, kamertemperatuur en een rustiger regeling
    Regeling (chofu_wp):
    - Modus auto / stooklijn / kamertemperatuur / handmatig. Stooklijn met twee
    punten (-10 en +15 graden) en een stookgrens; kamertemperatuur = stooklijn +
    kamerinvloed, met optionele nastelling en "uit als de kamer warm is".
    Zonder verse kamertemperatuur gaat de unit uit.
    - Middeling van aanvoer en retour, vooruitkijken, sneller terugschakelen,
    niet opschakelen zolang de aanvoer nog stijgt, van 0 naar 1 binnen 60 s.
    - Setpoint-oploop per minuut, die nooit onder de huidige aanvoer begint.
    - Delta-T-grens, maximale stand en vervaltijd instelbaar; 0 = vast plafond.
    - Sensoren D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
2026-10-17 Schema's van de IC1-adapter en de interfaceprint voor een losse buitenunit
    Alleen de schema's (PDF); geen Gerbers of KiCad-bestanden.
2026-10-17 Opschonen: geen lokale paden in de firmware-README, plafond-uitleg voor één unit
2026-10-18 Stuklijn: neutrale benaming voor een buitenunit zonder controlbox
    Het kopje en twee zinnen noemden "unit 2" en een "tweede buitenunit". Het gaat om
    de interfacehardware voor een buitenunit die zonder controlbox komt, en dat hoort
    er niet van afhankelijk te zijn of er een tweede unit is. De inhoud verandert niet.
2026-10-18 Screenshot van de webinterface bijgewerkt
    Het plaatje toont de nieuwe groepen (regeling, stooklijn en kamertemperatuur, instellingen) van
    de huidige firmware. Wifi-gegevens (SSID, BSSID, IP) zijn zwart gemaakt. De vorige versie blijft
    beschikbaar als docs/esphome-old.jpg.
2026-10-18 Handleiding installatie ESP32 + AVR-brug (A4, PDF + bron)
2026-10-22 Stopvertraging: compressor blijft draaien in plaats van aan/uit op stand 1
    Met warmtevraag mag de regeling pas van stand 1 naar 0 als hij dat een instelbare
    tijd (standaard 10 min) achter elkaar wil en een formule niet voorspelt dat hij
    meteen weer moet starten: voorspelde aanvoer na een stop = retour + (aanvoer - retour)
    x e^-t, met t de vooruitkijktijd. Zonder warmtevraag en bij koelen blijft het gedrag
    zoals voorheen; Stopvertraging op 0 schakelt de nieuwe regel uit.
2026-10-25 Credits: WackoH als bron van protocol en eerste sketches, JGC kleiner
    WackoH reverse-engineerde het protocol en schreef de eerste ATmega2560-sketches
    (02-03-2025 en 19-03-2025); JGC's bewerking daarvan was onze eerste basis.
    README en code-commentaar aangepast, geen functionele wijziging.
2026-10-25 Minimaal voorbeeld: Stopvertraging toegevoegd
    De instelling stond alleen in aurea-wp.yaml; wie het minimale voorbeeld gebruikte
    miste hem (gemeld door JGC).
2026-10-26 Reverse-engineering van de originele controlbox toegevoegd (volledige analyse)
    Nieuwe map reverse-engineering/: verslag (index.html, met een lijst correcties),
    het volledige analyserapport met dekking van alle flash-bytes, de functies, de
    telegramketen en de emulatie, de analyse- en emulatiescripts en de bijgewerkte
    C-reconstructies. De ruwe dumps en de volledige disassembly zijn niet
    opgenomen. Correcties doorgevoerd in docs (dip 2, PB3).
2026-10-26 README: elk 0x91-bericht eindigt met een 00-eindbyte
    Gecorrigeerd op aanwijzing van WackoH (ruwe seriele log van ruim 23.000 frames):
    de lengtebyte + 1 telt de eindbyte mee en de CRC staat op de twee bytes ervoor.
2026-10-26 Extra waarden uit de buitenunit als sensoren (byte-map van WackoH, issue #1)
    Compressorfrequentie (ID3 byte 3 x 2/3), stroom (byte 9 / 5), ventilator en ventilator-setpoint, expansieventiel,
    ontdooi-, zuig-, persgas- en watertemperatuur, ontdooien actief (ID1 byte 4 en ID3 byte 8) en de statusbyte, als
    sensoren in groep Diagnose. README: byte 9 van ID3 is de stroom, niet de compressorsnelheid. ID3 byte 13 (pompbyte bij
    WackoH) staat op onze units constant op 24. Gecompileerd met ESPHome 2026.10.0.
2026-10-26 Minimaal voorbeeld: extra waarden uit de buitenunit als sensoren
    Dezelfde sensoren als in aurea-wp.yaml (byte-map van WackoH, issue #1): frequentie, stroom, ventilator, expansieventiel,
    vier temperaturen, ontdooien en de statusbyte. Gecompileerd met ESPHome 2026.10.0.
2026-10-27 Keteltype: Onbekend zolang de brug niet verbonden is
    Zonder bericht van de AVR is het dipswitch-bit nooit gelezen en toonde de
    sensor de beginwaarde 'Aan/uit-ketel' alsof het een meting was.
2026-11-02 Stroom buitenunit uit ID3 byte 10 (0,1 A), byte 9 volgt het vermogen
    Over 48 uur tegen een Shelly gelegd: byte 10 = 24 W per telling + ~100 W
    voor pomp en elektronica (230 V x 0,1 A = 23 W), byte 9 loopt er recht
    mee maar is geen stroom. Eerder stond byte 9 / 5 als ampere in de sensor
    (20 A voor 2 kW). Zie ook de byte-map van WackoH.
2026-11-02 Hysterese van 'Uit als de kamer warm is' los instelbaar (boven en onder)
    Twee nieuwe instellingen, 'Kamer: uit boven doel' en 'Kamer: aan onder doel'
    (0-1 °C, standaard 0,2 zoals voorheen). Idee van _JGC_ op Tweakers.
2026-11-02 Kamer: minimale schakeltijd tegen pendelen bij 'Uit als de kamer warm is'
    Na een wisseling van de kamervraag blijft die minimaal N minuten staan
    (0 = uit, zoals voorheen, tot 120). Naar aanleiding van tuanpm519 op Tweakers.
2026-11-02 README: uitleg cycli bij 'Uit als de kamer warm is' uit (issue 2)
2026-11-03 AVR-brug v2: component aurea_link2, firmware, hex en docs
    Component, AVR-bron en hex uit de branch avr-v2, zonder het woord experimenteel.
    De hex komt met een uitzondering in firmware/.gitignore mee, zoals die van v1.
2026-11-03 aurea-wp.yaml: keuze tussen AVR v1 en v2, buitentemperatuur-schakelaar, vlaggen onder Diagnose
    - avr_versie bovenin; de placeholder laat de config bewust falen.
    - avr-brug-v1.yaml en avr-brug-v2.yaml bevatten wat van de AVR-versie afhangt.
    - Schakelaar 'Buitentemperatuur aan thermostaat' (standaard uit, alleen vanaf AVR v2).
    - Thermostaat-vlag per AVR-versie; verbonden-vlaggen en AVR-versie onder Diagnose.
    - README: tabel v1 tegen v2, route B met remote package.
2026-11-03 README route B: files als blokijst (een flow-lijst met ${...} breekt de YAML)
    Getest met esphome config op branch v2-test: avr_versie 1 en 2 valideren, de placeholder faalt met
    'avr-brug-vKIES_1_OF_2_... does not exist in repository'.
2026-11-03 Docs: status en claims voor AVR v2 en v1
    - v2: draait sinds 26-10-2026 op een opstelling (OpenTherm-ketel, Remeha iSense); andere ketels en thermostaten niet getest.
    - Honeywell Chronotherm Touch en Remeha iSense werken met v2.
    - Oude waarschuwing over de PC-tests uit de firmware-README gehaald.
    - v1 blijft voor bestaande opstellingen; na de herstructurering niet op hardware gedraaid; terugvallen kan op de tag voor-v2.
2026-11-03 avr_versie "org": originele IC2 (Haddon T1.1) in de IC2-voet
    Derde keuze naast v1 en v2 voor wie geen AVR kan programmeren. Component
    aurea_link_org speelt de originele IC1 (M1.1) over de bestaande 9615-baud-link
    (8N2, 12 bytes + som). Zelfde publieke methodes als aurea_link, zodat
    aurea-wp.yaml bijna ongewijzigd blijft; wat de IC2 niet doorgeeft toont
    "onbekend". Optie org_alleen_luisteren voor een eerste test.
    Experimenteel: frame afgeleid uit firmware en emulator, nog niet op een echte
    IC2 geprobeerd. Compileert; v1 en v2 valideren nog.
2026-11-04 README route B: refresh hoort bij external_components en packages, niet in source (getest in de HA-builder)
    Route B (remote external_components + packages, avr_versie 2) compileert in de HA-builder (ESPHome 2026.10.2).
2026-11-04 README: een verhaal over de keuze in IC1 en IC2
    Vergelijkingstabel van de vier opzetten (minimaal, originele IC2, eigen AVR v1
    en v2) met wat elke keuze oplevert, een keuzehulp, en de installatiestappen
    en het Device Builder-voorbeeld bijgewerkt voor "org" (aurea_link_org ontbrak
    in de componentenlijst). Verwijzingen in firmware/README.md en docs/avr-v2.md.
2026-11-09 Ketelkant: schakelaars voor polariteit en kanaalwissel plus ketel-diagnosesensoren (AVR v1 en v2)
    Drie handschakelaars (leesrichting, zendpolariteit, kanalen verwisselen, standaard uit) en vier diagnosesensoren
    (flanken, leesfouten, pariteitsfouten, ruwe lijnen) voor ketels waarbij Ketel verbonden uit blijft. De AVR leest de
    vlaggen uit het commando van de ESP en hoeft niet opnieuw geflasht. Alleen bij avr_versie 1 en 2, niet bij org.
    Gevalideerd met esphome config voor v1 en v2.
2026-11-10 AVR v2: schakelaar "Ketel aan-uit-contact" (K3) en twee diagnosesensoren
    Zet keteltype aan/uit en vrijgave K3 vanuit de ESP. De AVR-v2-firmware had dit al
    (geen OpenTherm naar de ketel, K3 bij setpoint >= 20 C zonder rem, interlock met de
    noodbrug). Standaard uit: bestaande opstellingen veranderen niet. Niet op hardware getest.
2026-11-10 K3 aan/uit-ketel voor AVR v1 en originele IC2 gedocumenteerd; pagina ESP bijwerken zonder HA
    - avr-brug-v1.yaml: schakelaar "Ketel aan-uit-contact" (standaard uit) en sensor K3
    - aurea-wp.yaml: oude uitgecommentarieerde K3-blokken vervangen door een verwijzing
    - avr-brug-vorg.yaml: aan/uit-ketel met dipswitch 2 OFF beschreven
    - README: tabelregel en alinea over K3, link naar de nieuwe pagina
    - docs/esp-updaten-zonder-ha.md: ESPHome-cli, dashboard en ESPHome Web
    Niet op hardware getest; esphome config slaagt voor v1, v2 en org.
